bradstv/vr-gloves/README.md

# Virtual Reality Glove with Thermal, Haptic, and Force Feedback
A Senior Design (EET4166C) Project by: Brad Alvarez and Yeshaya Zweig

## Paper
Link to the final paper [here](https://github.com/bradstv/vr-gloves/blob/main/assets/VR%20Glove%20Paper%20-%20Senior%20Design%20-%20Brad%20and%20Yeshaya.pdf)

## Video
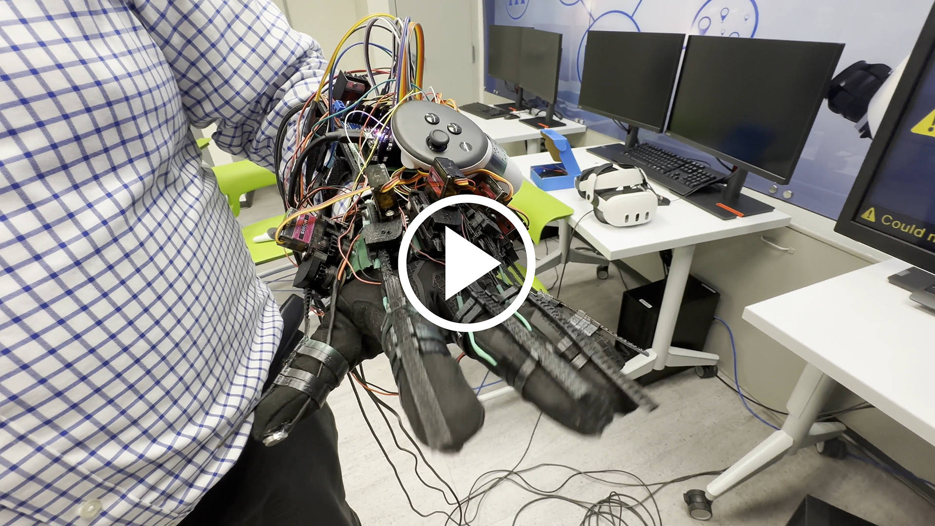
[picture p1: assets/video-thumbnail.jpg]
Video Link (https://www.youtube.com/watch?v=__TTQ2mKOUs)


## Schematic
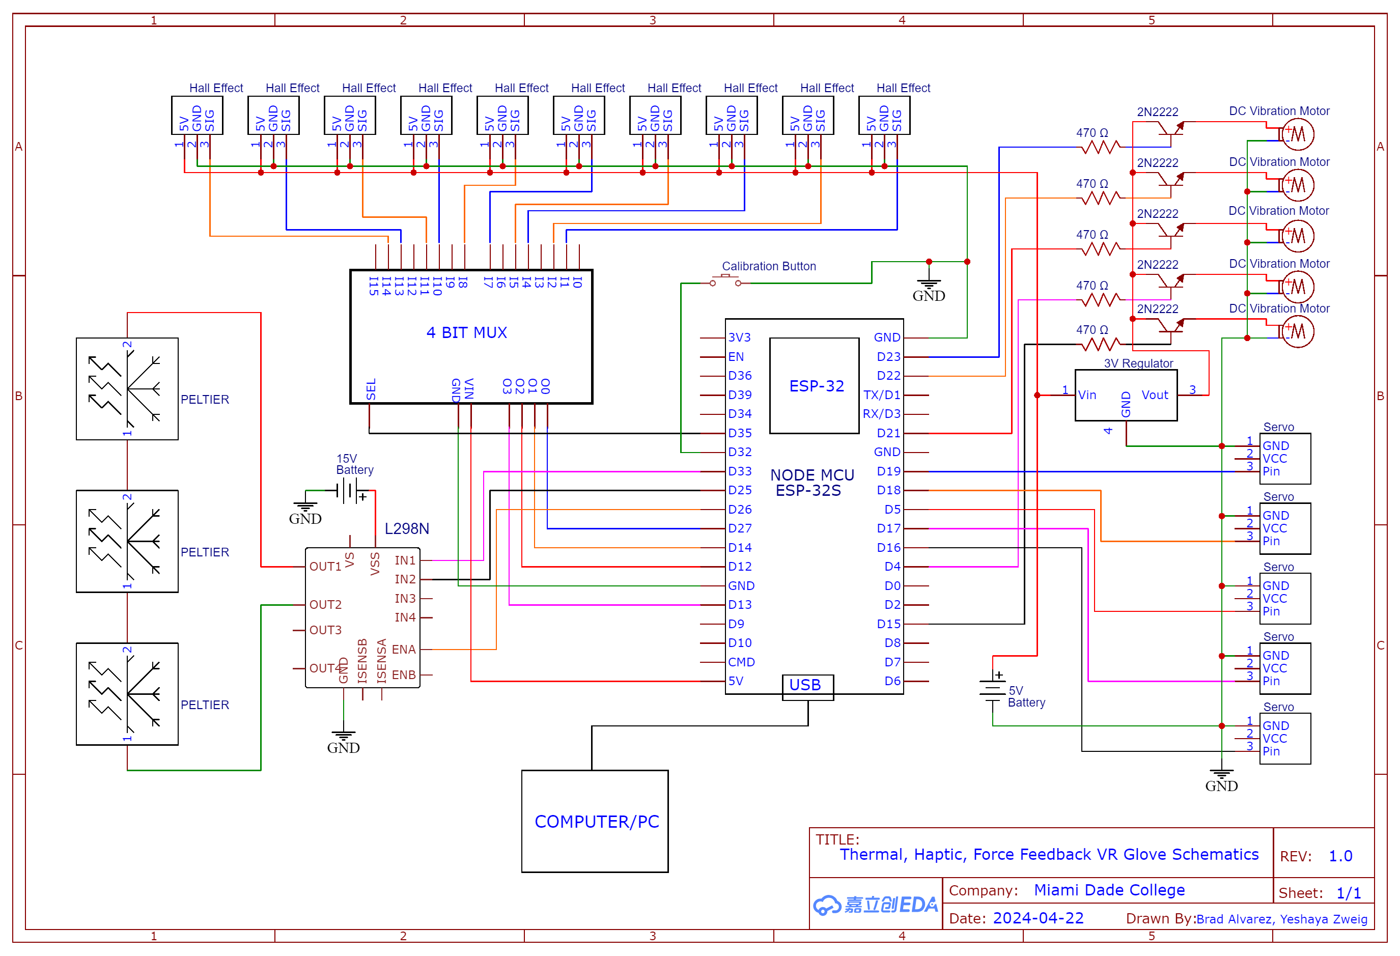
[picture p2: assets/VR Glove Schematic - Senior Design - Brad and Yeshaya.png]
Schematic


## Binaries 
You can find binaries (executables) for our Driver, Driver UI, and Unity Demo in [Releases](https://github.com/bradstv/vr-gloves/releases)

### Credits
Thanks to @LucidVR and orignal contributors for a base VR Glove Driver and UI to work off of
