bradstv/vr-gloves/gloves-unity/Assets/Custom Textures/Calculator Buttons.png

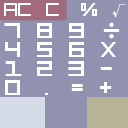
gloves-unity/Assets/Custom Textures/Calculator Buttons.png
