bradstv/vr-gloves/gloves-unity/Assets/Models/Cola Can/Model/Textures/cola_can_metallic.png

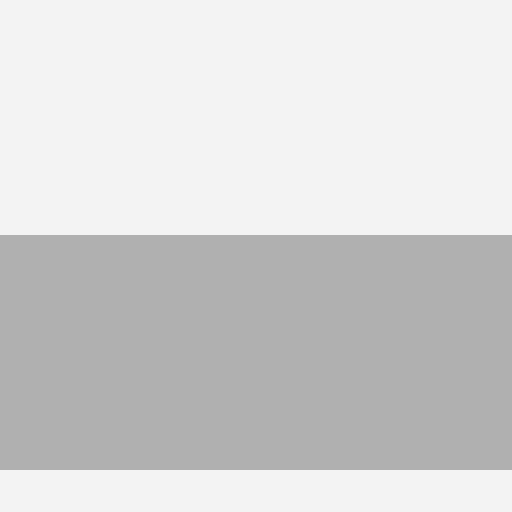
gloves-unity/Assets/Models/Cola Can/Model/Textures/cola_can_metallic.png
