bradstv/vr-gloves/gloves-unity/Assets/Office Supplies Low Poly/Assets/Textures/Office Supplies Low Poly Shared Texture.png

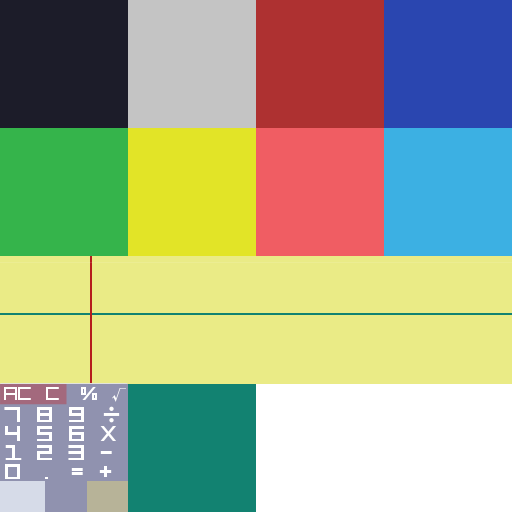
gloves-unity/Assets/Office Supplies Low Poly/Assets/Textures/Office Supplies Low Poly Shared Texture.png
