bradstv/vr-gloves/gloves-unity/Assets/Piloto Studio/Shaders/SimplyToon_Piloto/Gradient.png

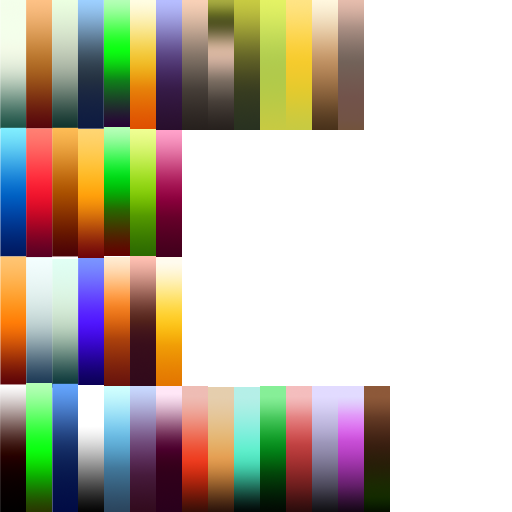
gloves-unity/Assets/Piloto Studio/Shaders/SimplyToon_Piloto/Gradient.png
