bradstv/vr-gloves/gloves-unity/Assets/Piloto Studio/Textures/FireNoise.png

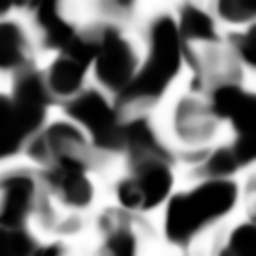
gloves-unity/Assets/Piloto Studio/Textures/FireNoise.png
