bradstv/vr-gloves/gloves-unity/Assets/Piloto Studio/Textures/FireQuad_Stylized.png

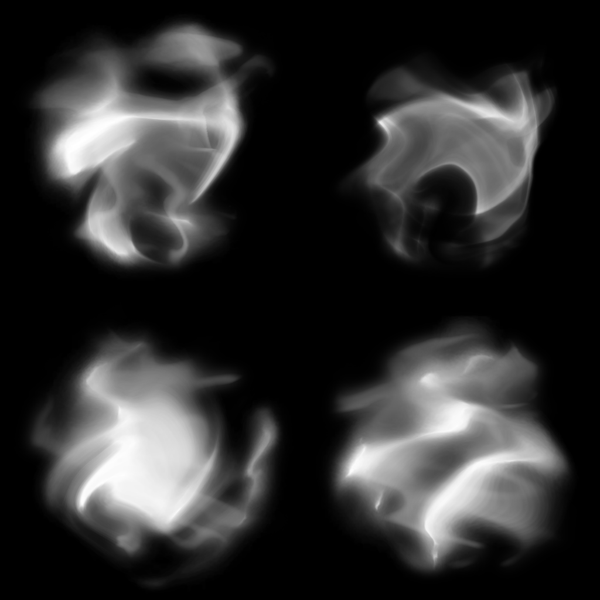
gloves-unity/Assets/Piloto Studio/Textures/FireQuad_Stylized.png
