bradstv/vr-gloves/gloves-unity/Assets/Piloto Studio/Textures/Flare_Cross.png

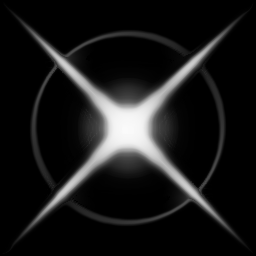
gloves-unity/Assets/Piloto Studio/Textures/Flare_Cross.png
