bradstv/vr-gloves/gloves-unity/Assets/Piloto Studio/Textures/Flare_FatDot.png

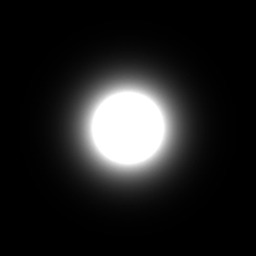
gloves-unity/Assets/Piloto Studio/Textures/Flare_FatDot.png
