bradstv/vr-gloves/gloves-unity/Assets/Piloto Studio/Textures/Flare_Glowdot.png

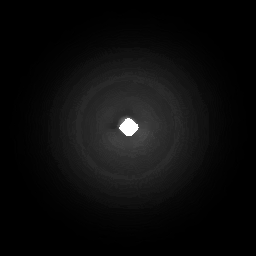
gloves-unity/Assets/Piloto Studio/Textures/Flare_Glowdot.png
