bradstv/vr-gloves/gloves-unity/Assets/Piloto Studio/Textures/Glowdots_Speckles.png

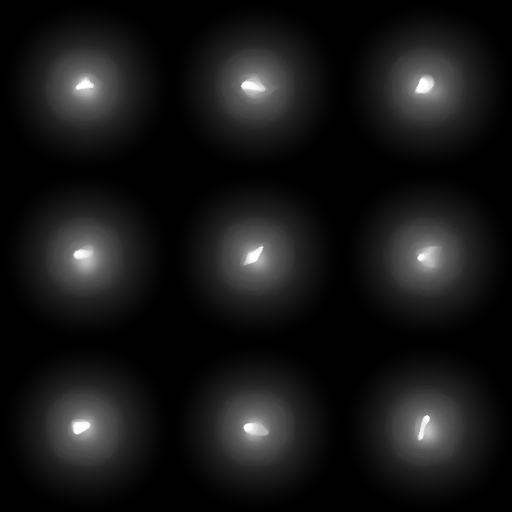
gloves-unity/Assets/Piloto Studio/Textures/Glowdots_Speckles.png
