bradstv/vr-gloves/gloves-unity/Assets/Piloto Studio/Textures/gradient_004.png

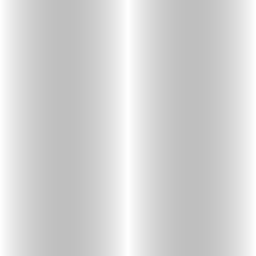
gloves-unity/Assets/Piloto Studio/Textures/gradient_004.png
