bradstv/vr-gloves/gloves-unity/Assets/Piloto Studio/Textures/HalftoneCrescent.png

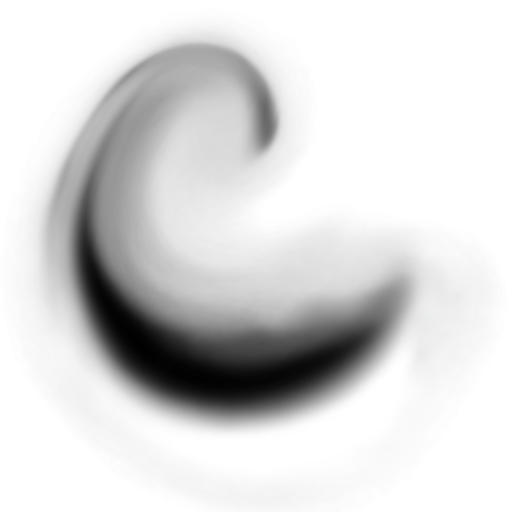
gloves-unity/Assets/Piloto Studio/Textures/HalftoneCrescent.png
