bradstv/vr-gloves/gloves-unity/Assets/Piloto Studio/Textures/PackedNoises_Generic.png

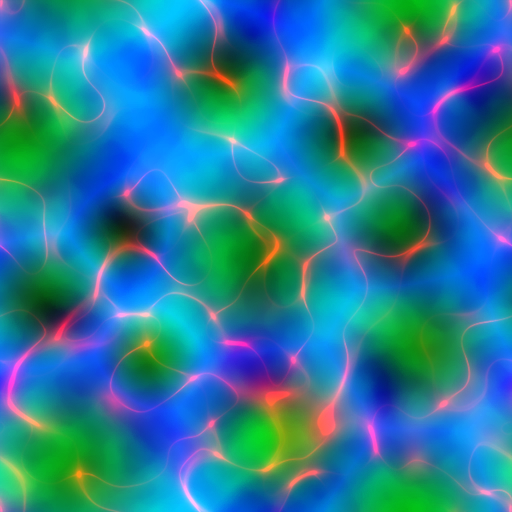
gloves-unity/Assets/Piloto Studio/Textures/PackedNoises_Generic.png
