bradstv/vr-gloves/gloves-unity/Assets/Piloto Studio/Textures/SmokeHarsh_BlackSpots.png

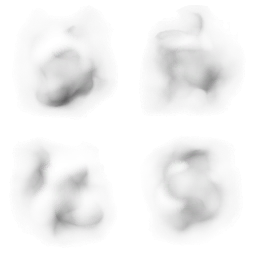
gloves-unity/Assets/Piloto Studio/Textures/SmokeHarsh_BlackSpots.png
