bradstv/vr-gloves/gloves-unity/Assets/Piloto Studio/Textures/Trail_WispyGeneric.png

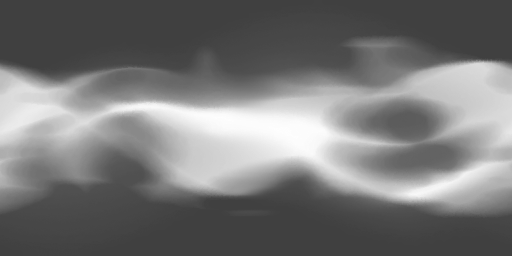
gloves-unity/Assets/Piloto Studio/Textures/Trail_WispyGeneric.png
