bradstv/vr-gloves/gloves-firmware/AdvancedConfig.h

//Advanced settings, only for the pros XD

#define LOOP_TIME 1 //How much time between data sends (ms), set to 0 for a good time :)
#define CALIBRATION_LOOPS -1//How many loops should be calibrated. Set to -1 to always be calibrated.

#define NUM_FINGERS 5

//Finger indeces
#define PINKY_IND 4
#define RING_IND 3
#define MIDDLE_IND 2
#define INDEX_IND 1
#define THUMB_IND 0

#define ANALOG_MAX 4095
#define GRAB_MIN ANALOG_MAX/3
#define SERVO_MAX 144.0f

#define MULTIPLEXER_DELAY   5 //How many microseconds should be delayed between multiplexer reads

//Filtering and clamping analog inputs
#define CLAMP_ANALOG_MAP true //clamp the mapped analog values from 0 to ANALOG_MAX

// Enable and set min and max to match your sensor's expected raw value range
// This discards any spurious values outside of the useful range
#define CLAMP_SENSORS false  //clamp the raw sensor values
#define CLAMP_MIN 0  //the minimum value from the flexion sensors
#define CLAMP_MAX ANALOG_MAX  //the maximum value from the flexion sensors

// You must install RunningMedian library to use this feature
// https://www.arduino.cc/reference/en/libraries/runningmedian/
#define ENABLE_MEDIAN_FILTER false //use the median of the previous values, helps reduce noise
#define MEDIAN_SAMPLES 10

//intermediate filtering. Options are INTERFILTER_NONE, INTERFILTER_LIMITS (filter is only used for limit calib), INTERFILTER_ALL (filter all the way)
#define INTERFILTER_MODE INTERFILTER_ALL
#define INTERFILTER_SAMPLES 10
