bradstv/vr-gloves/gloves-firmware/input.ino

#include <esp_adc_cal.h>
#include <EEPROM.h>
// Requires RunningMedian library by Rob Tillaart
#include <RunningMedian.h>

#if ENABLE_MEDIAN_FILTER
RunningMedian rmSamples[NUM_FINGERS] = {
    RunningMedian(MEDIAN_SAMPLES),
    RunningMedian(MEDIAN_SAMPLES),
    RunningMedian(MEDIAN_SAMPLES),
    RunningMedian(MEDIAN_SAMPLES),
    RunningMedian(MEDIAN_SAMPLES)
};
#endif

RunningMedian sinSamples[NUM_FINGERS] = {
    RunningMedian(INTERFILTER_SAMPLES),
    RunningMedian(INTERFILTER_SAMPLES),
    RunningMedian(INTERFILTER_SAMPLES),
    RunningMedian(INTERFILTER_SAMPLES),
    RunningMedian(INTERFILTER_SAMPLES)
};

RunningMedian cosSamples[NUM_FINGERS] = {
    RunningMedian(INTERFILTER_SAMPLES),
    RunningMedian(INTERFILTER_SAMPLES),
    RunningMedian(INTERFILTER_SAMPLES),
    RunningMedian(INTERFILTER_SAMPLES),
    RunningMedian(INTERFILTER_SAMPLES)
};

#define DEFAULT_VREF 1100
esp_adc_cal_characteristics_t *adc_chars;

byte selectPins[] = {PINS_MUX_SELECT};

int maxFingers[NUM_FINGERS] = {0,0,0,0,0};
int minFingers[NUM_FINGERS] = {ANALOG_MAX, ANALOG_MAX, ANALOG_MAX, ANALOG_MAX, ANALOG_MAX};
int maxTravel[NUM_FINGERS] = {ANALOG_MAX, ANALOG_MAX, ANALOG_MAX, ANALOG_MAX, ANALOG_MAX};

int sinMin[NUM_FINGERS] = {ANALOG_MAX, ANALOG_MAX, ANALOG_MAX, ANALOG_MAX, ANALOG_MAX};
int sinMax[NUM_FINGERS] = {0,0,0,0,0};

int cosMin[NUM_FINGERS] = {ANALOG_MAX, ANALOG_MAX, ANALOG_MAX, ANALOG_MAX, ANALOG_MAX};
int cosMax[NUM_FINGERS] = {0,0,0,0,0};

bool atanPositive[NUM_FINGERS] = {true, true, true, true, true};

int totalOffset1[NUM_FINGERS] = {0,0,0,0,0};

bool savedInter = false;
bool savedTravel = false;

void setupInputs()
{
    EEPROM.begin(0x78 + 1);
    Serial.println("Setting up inputs!");
    if (isSavedLimits())
    {
        Serial.println("Is saved limits!");
        savedTravel = true;
        loadTravel();
    }

    if (isSavedIntermediate())
    {
        Serial.println("IsSavedIntermediate!");
        savedInter = true;
        loadIntermediate();
    }

    pinMode(PIN_CALIB, INPUT_PULLUP);

    byte selectPins[] = {PINS_MUX_SELECT};
    pinMode(MUX_INPUT, INPUT);
    for (int i = 0; i < sizeof(selectPins); i++)
    {
        pinMode(selectPins[i], OUTPUT);
    }
}

int analogPinRead(int pin)
{
    if (ISMUX(pin))
    {
        return readMux(UNMUX(pin));
    }
    else
    {
        return analogRead(pin);
    }
}

int readMux(byte pin)
{
    int numSelectPins = sizeof(selectPins) / sizeof(selectPins[0]);

    for (int i = numSelectPins - 1; i > -1; i--)
    {
        digitalWrite(selectPins[i], (pin & (1 << i)) ? HIGH : LOW);
    }

    delayMicroseconds(MULTIPLEXER_DELAY);
    return analogRead(MUX_INPUT);
}

int targetSinMin, targetSinMax, targetSinCurrent, targetCosMin, targetCosMax, targetCosCurrent, targetFlexionMin, targetFlexionMax, targetFlexionCurrent, targetMaxTravel, targetProcessed;
void getFingerPositions(bool calibrating, bool reset)
{
    int rawFingersFlexion[NUM_FINGERS] = {sinCosMix(PIN_THUMB, PIN_THUMB_SECOND, 0 ), 
                                    sinCosMix(PIN_INDEX, PIN_INDEX_SECOND, 1 ), 
                                    sinCosMix(PIN_MIDDLE,PIN_MIDDLE_SECOND,2 ), 
                                    sinCosMix(PIN_RING,  PIN_RING_SECOND,  3 ), 
                                    sinCosMix(PIN_PINKY, PIN_PINKY_SECOND, 4 )};
    
    int rawFingers[NUM_FINGERS];
    
    for (int i = 0; i < NUM_FINGERS; i++)
    {
        rawFingers[i] = rawFingersFlexion[i];
    }

    #if FLIP_FLEXION
    for (int i = 0; i < NUM_FINGERS; i++)
    {
        rawFingers[i] = ANALOG_MAX - rawFingers[i];
    }
    #endif

    #if ENABLE_MEDIAN_FILTER
    for (int i = 0; i < NUM_FINGERS; i++)
    {
        rmSamples[i].add( rawFingers[i] );
        rawFingers[i] = rmSamples[i].getMedian();
    }
    #endif

    //reset max and mins as needed
    if (reset)
    {
        for (int i = 0; i < NUM_FINGERS; i++)
        {
            totalOffset1[i] = 0;
            maxFingers[i] = INT_MIN;
            minFingers[i] = INT_MAX;
        }
    }

    //if during the calibration sequence, make sure to update max and mins
    if (calibrating)
    {
        for (int i = 0; i < NUM_FINGERS; i++)
        {
            if (rawFingers[i] > maxFingers[i])
            {
                #if CLAMP_SENSORS
                maxFingers[i] = ( rawFingers[i] <= CLAMP_MAX )? rawFingers[i] : CLAMP_MAX;
                #else
                maxFingers[i] = rawFingers[i];
                if (savedTravel && (maxFingers[i] - minFingers[i] > maxTravel[i]))
                    minFingers[i] = maxFingers[i] - maxTravel[i];
                #endif
            }
            if (rawFingers[i] < minFingers[i])
            {
                #if CLAMP_SENSORS
                minFingers[i] = ( rawFingers[i] >= CLAMP_MIN )? rawFingers[i] : CLAMP_MIN;
                #else
                minFingers[i] = rawFingers[i];
                if (savedTravel && (maxFingers[i] - minFingers[i] > maxTravel[i]))
                    maxFingers[i] = minFingers[i] + maxTravel[i];
                #endif
            }
        }
    }

    for (int i = 0; i < NUM_FINGERS; i++)
    {
        if (i == target)
        {
            targetFlexionMin = minFingers[i];
            targetFlexionMax = maxFingers[i];
            targetFlexionCurrent = rawFingers[i];
            targetMaxTravel = maxTravel[i];
        }
        if (minFingers[i] != maxFingers[i])
        {
            fingerPos[i] = map( rawFingers[i], minFingers[i], maxFingers[i], 0, ANALOG_MAX );
            if (i == target)
            {
                targetProcessed = fingerPos[i];
            }
            #if CLAMP_ANALOG_MAP
            if (fingerPos[i] < 0)
            {
                fingerPos[i] = 0;
            }
            if (fingerPos[i] > ANALOG_MAX)
            {
                fingerPos[i] = ANALOG_MAX;
            }  
            #endif
        }
        else 
        {
            fingerPos[i] = ANALOG_MAX / 2;
        }
    }
}

bool getButton(byte pin)
{
    return digitalRead(pin) != HIGH;
}

int sinCosMix(int sinPin, int cosPin, int i)
{
    int sinRaw = analogPinRead(sinPin);
    int cosRaw = analogPinRead(cosPin);

    #if INTERFILTER_MODE != INTERFILTER_NONE
    sinSamples[i].add(sinRaw);
    cosSamples[i].add(cosRaw);
    int sinCalib = sinSamples[i].getMedian();
    int cosCalib = cosSamples[i].getMedian();
    #if INTERFILTER_MODE == INTERFILTER_ALL
    sinRaw = sinCalib;
    cosRaw = cosCalib;
    #endif
    #else
    int sinCalib = sinRaw;
    int cosCalib = cosRaw;
    #endif 

    if (!savedInter)
    {
        //scaling
        sinMin[i] = min(sinCalib, sinMin[i]);
        sinMax[i] = max(sinCalib, sinMax[i]);

        cosMin[i] = min(cosCalib, cosMin[i]);
        cosMax[i] = max(cosCalib, cosMax[i]);
    }

    if (i==target)
    {
        targetSinMin = sinMin[i];
        targetSinMax = sinMax[i];
        targetSinCurrent = sinRaw;
        targetCosMin = cosMin[i];
        targetCosMax = cosMax[i];
        targetCosCurrent = cosRaw;
    }

    int sinScaled = map(sinRaw, sinMin[i], sinMax[i], -ANALOG_MAX, ANALOG_MAX);
    int cosScaled = map(cosRaw, cosMin[i], cosMax[i], -ANALOG_MAX, ANALOG_MAX);

    //trigonometry stuffs
    double angleRaw = atan2(sinScaled, cosScaled);

    //counting rotations
    if (((angleRaw > 0) != atanPositive[i]) && sinScaled > cosScaled)
    {
        totalOffset1[i] += atanPositive[i]?1:-1;
    }
    atanPositive[i] = angleRaw > 0;
    double totalAngle = angleRaw + 2*PI * totalOffset1[i];

    return (int)(totalAngle * ANALOG_MAX);
}

void saveTravel()
{
    byte flags = EEPROM.read(0x00);
    flags |= 0x01;  // Set bit 0
    EEPROM.write(0x00, flags); // Save clamping saved limits flag

    int addr = 0x01;  // Start address for flexion values

    for (int i = 0; i < NUM_FINGERS; i++) 
    {
        int diff = maxFingers[i] - minFingers[i]; // Calculate the difference
        EEPROM.put(addr, diff); // Store the difference into the EEPROM at the current address
        addr += sizeof(int); // Increment the address by 4 because we're storing int values
    }
    
    EEPROM.commit(); // Ensure changes are written to EEPROM

    loadTravel();
}

void saveIntermediate()
{
    byte flags = EEPROM.read(0x00);
    flags |= 0x02;  // Set bit 1
    EEPROM.write(0x00, flags); // Save intermediate values saved flag

    int address = 0x29; // Start address for sin and cos values

    for(int i = 0; i < NUM_FINGERS; i++)
    {
        EEPROM.put(address, sinMax[i]);
        address += sizeof(int);
        EEPROM.put(address, sinMin[i]);
        address += sizeof(int);
        EEPROM.put(address, cosMax[i]);
        address += sizeof(int);
        EEPROM.put(address, cosMin[i]);
        address += sizeof(int);
    }
    
    EEPROM.commit(); // Ensure changes are written to EEPROM
}

void clearFlags()
{
    EEPROM.write(0x00, 0x00); // Clear the flags
    EEPROM.commit(); // Ensure the changes are written to EEPROM
}

bool isSavedLimits()
{
    byte flags = EEPROM.read(0x00);
    return flags & 0x01;  // Check bit 0
}

bool isSavedIntermediate()
{
    byte flags = EEPROM.read(0x00);
    return flags & 0x02;  // Check bit 1
}

void loadTravel()
{
    byte flags = EEPROM.read(0x00);
    if (!(flags & 0x01)) return; // If clamping saved limits flag is not set, do nothing

    int addr = 0x01;  // Start address for flexion values

    for (int i = 0; i < NUM_FINGERS; i++) 
    {
        EEPROM.get(addr, maxTravel[i]); // Load the max travel value from the EEPROM at the current address
        addr += sizeof(int); // Increment the address by 4 because we're storing int values
    }
}

void loadIntermediate()
{
    byte flags = EEPROM.read(0x00);
    if (!(flags & 0x02)) return; // If intermediate values saved flag is not set, do nothing

    int address = 0x29; // Start address for sin and cos values

    for(int i = 0; i < NUM_FINGERS; i++)
    {
        EEPROM.get(address, sinMax[i]);
        address += sizeof(int);

        EEPROM.get(address, sinMin[i]);
        address += sizeof(int);

        EEPROM.get(address, cosMax[i]);
        address += sizeof(int);

        EEPROM.get(address, cosMin[i]);
        address += sizeof(int);
    }
}
