bradstv/vr-gloves/(commit log)

2023-11-20 update unity, firmware, and add driver
2024-01-07 Add buzzer support for each finger (not tested)
    [encoding.ino, feedback.ino]
2024-02-16 add stuff
    adds player movement in unity
    adds pcbs
    changes firmware to test thumb
2024-02-26 add more stuff
    - add driver ui with thermal and haptic calibration funcs
    - add thermal and haptic ui callbacks to driver
    - rename "thermo" to "thermal"
    - rename "buzzer" to "haptic"
    - use finger indices for feedback in firmware
    - pin definition changes for more testing
    - more small stuff prob, idk
    [encoding.ino, feedback.ino, gloves-firmware.ino, input.ino]
2024-02-27 flip mux pin order
    [gloves-firmware.ino]
2024-03-05 more stuff
    -unity changes (add some props and hand poses)
    -add back mux pins for flexion in firmware
    -remove some splay stuff
2024-03-09 stuff
    -fix multiplexer in firmware
    -clamp servo angles to 144 in firmware
    -more poses in unity
    -add two different interactions for haptics and thermals (trigger when object grabbed and/or always trigger based on radius)
    -remove unused pcbs
    [AdvancedConfig.h, encoding.ino, feedback.ino, gloves-firmware.ino, input.ino]
2024-03-15 better calibration
2024-03-16 add finger calib save/clear to ui
2024-03-24 Add and fix more stuff
    Unity:
    -Refactor FFB Client
    -Fix thermal mapping
    -Better log prints
    -Add and code working calculator object
    -Fix hand poses on custom objects
    Firmware:
    -Remove unused definitions in config (splay, servo scaling)
    -Remove unused splay stuff
    [encoding.ino, gloves-firmware.ino, input.ino]
2024-04-23 add schematic to readme
